freecores/usbhostslave/(list of files, cad)

Other CAD files:
usbDevice/syn/Actel/usbDeviceActelTop/designer/impl1/usbDeviceActelTop.stp
