freecores/usbhostslave/usbDevice/syn/Actel/usbDeviceActelTop/hdl/timescale.v

//////////////////////////////////////////////////////////////////////
// timescale.v                                              
//////////////////////////////////////////////////////////////////////
`timescale 1ns / 1ps
