freecores/usbhostslave/(commit log)

2008-03-22 Revision 1.3 - Fixed input metastability and delay hazard issue
    [readUSBWireData.v, usbHostSlave_h.v]
2008-08-25 usbHostSlave - Release 2.0. Seperate host and slave top level modules, in addition the original combined host/slave. Improved cross clock domain synchronisation. Fixed wishbone ack bug. Improved fifo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
    [usbDeviceActelTop.stp]
2008-08-25 usbHostSlave - Added missing files
    [usbHost.v, usbHostCyc2Wrap.v, usbHostSlaveCyc2Wrap.v, usbSlave.v, usbSlaveCyc2Wrap.v]
2010-10-09 Fixed bugs related to accessing low speed device via hub
    [SIETransmitter.v, processTxByte.v, sendpacketcheckpreamble.v, usbHost.v, usbHostSlave.v, usbHostSlave_h.v, usbSerialInterfaceEngine_h.v, usbSlave.v]
2011-03-18 usbhostslave Version 2.2 - Fixed bugs in low speed communications via hub. Increased delay from data in to ACK. Fixed low speed ACK SOF collision bug
    [processRxBit.v, softransmit.v, usbHostControl.v, usbHostControl_h.v, usbHostSlave_h.v, usbSerialInterfaceEngine.v]
2011-03-18 usbhostslave - Adjusted to SOF time to exactly 1mS. Was 83nS too long.
    [usbHostControl_h.v]
