freecores/usbhostslave/(notices)

Notices in the files:
usbDevice/syn/Actel/usbDeviceActelTop/hdl/fifoMux.v:
Copyright (C) 2004 Steve Fielding and OPENCORES.ORG
Public License as published by the Free Software Foundation;
Public License along with this source; if not, download it
from <http://www.opencores.org/lgpl.shtml>
usbDevice/syn/Actel/usbDeviceActelTop/hdl/usbDevice.v:
Copyright (C) 2008 Steve Fielding and OPENCORES.ORG
usbDevice/model/wb_master_model.v:
Copyright (C) 2001 Richard Herveille
Copyright (C) 2002 Authors
